SimonKrampe/Facharbeit-Informatik-Taschenrechner/Eagle/Renders/FinishedPCB_Bottom.png

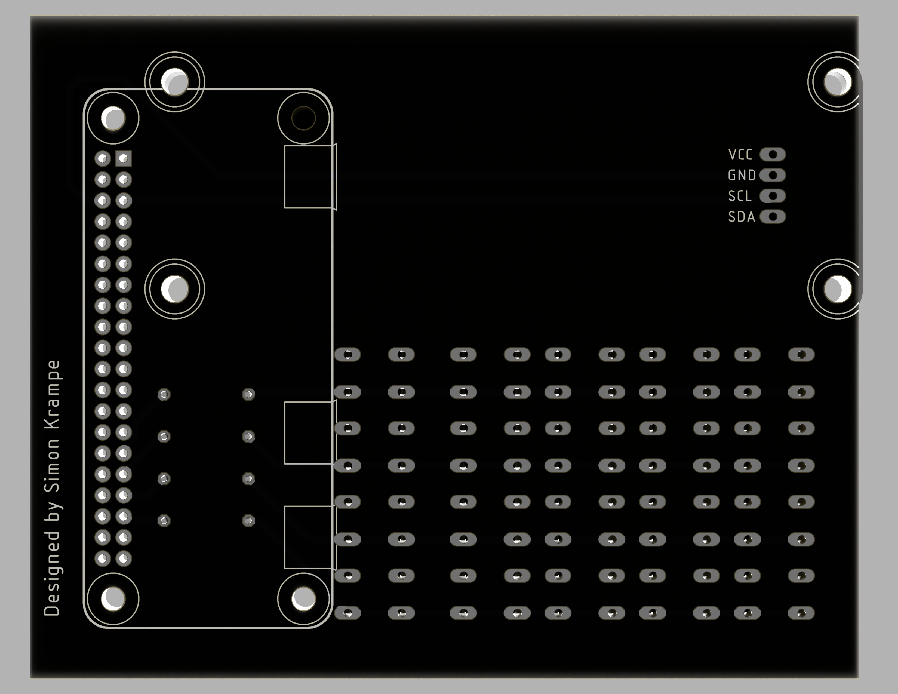
Eagle/Renders/FinishedPCB_Bottom.png
