SimonKrampe/Facharbeit-Informatik-Taschenrechner/Eagle/Renders/FinishedPCB_Clean.png

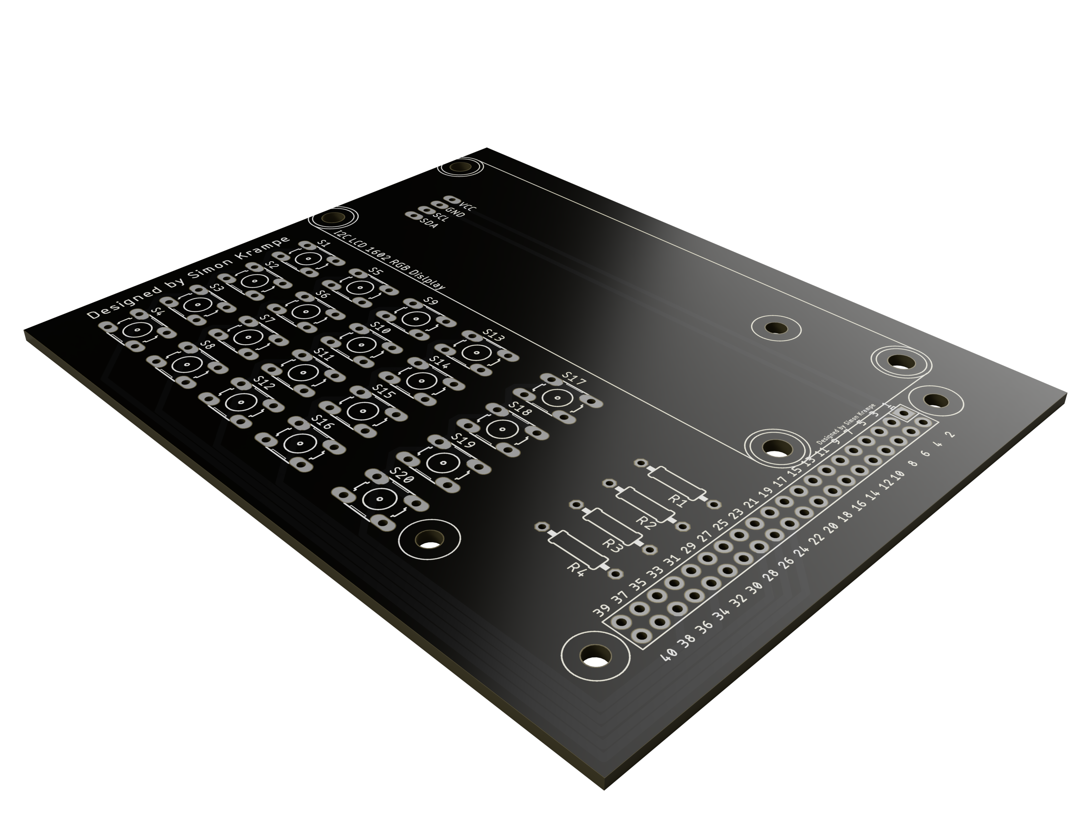
Eagle/Renders/FinishedPCB_Clean.png
