SimonKrampe/Facharbeit-Informatik-Taschenrechner/Eagle/Renders/FinishedPCB_Top_Clean.png

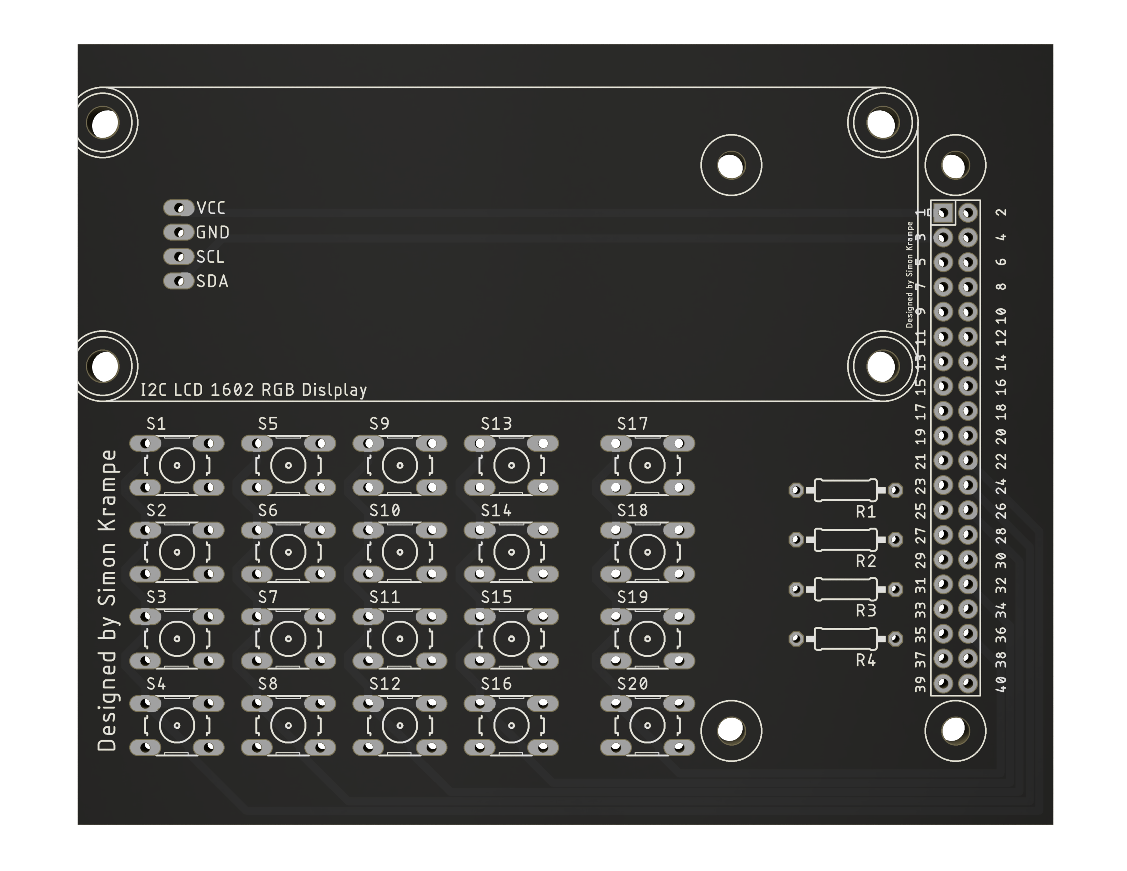
Eagle/Renders/FinishedPCB_Top_Clean.png
