SimonKrampe/Facharbeit-Informatik-Taschenrechner/Eagle/Renders/FinishedPCBAlternate.png

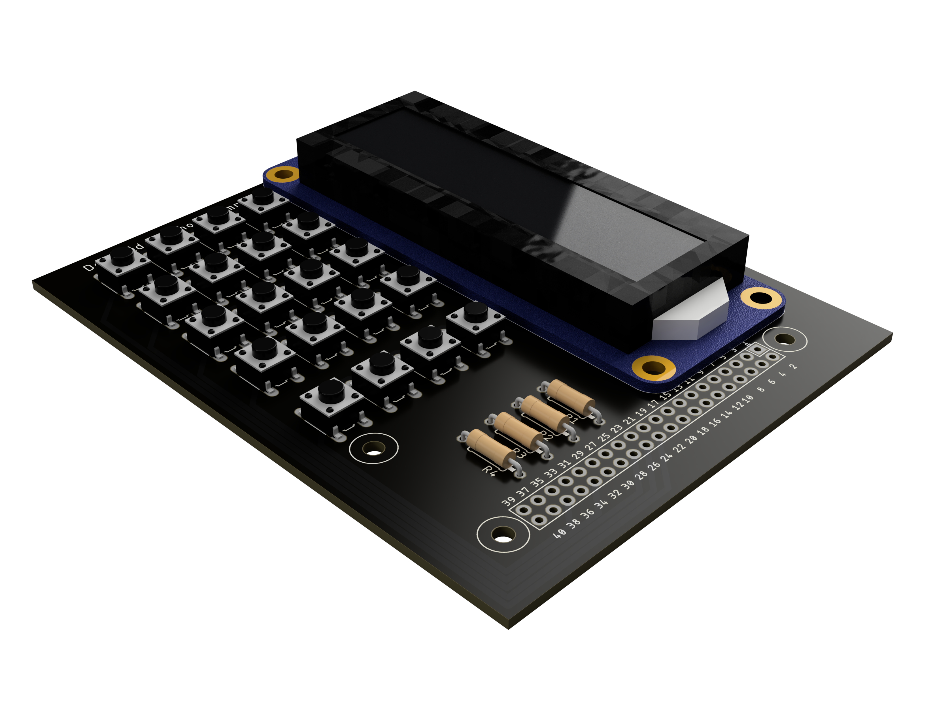
Eagle/Renders/FinishedPCBAlternate.png
