SimonKrampe/Facharbeit-Informatik-Taschenrechner/Fritzing/Button Matrix_Steckplatine4k.png

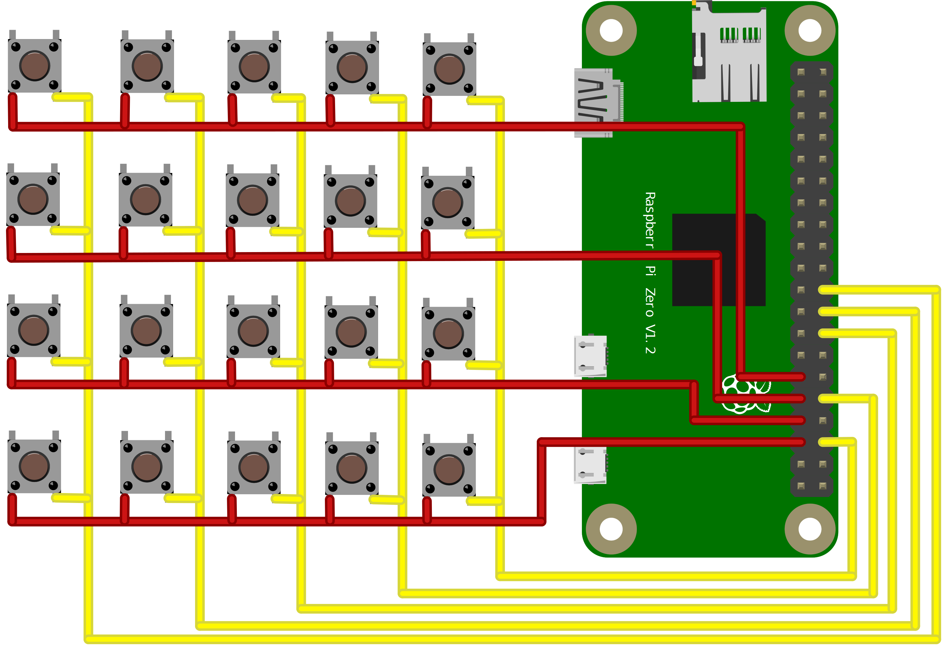
Fritzing/Button Matrix_Steckplatine4k.png
