SimonKrampe/Facharbeit-Informatik-Taschenrechner/Fritzing/Button Matrix_Steckplatine4k_Beschriftet.png

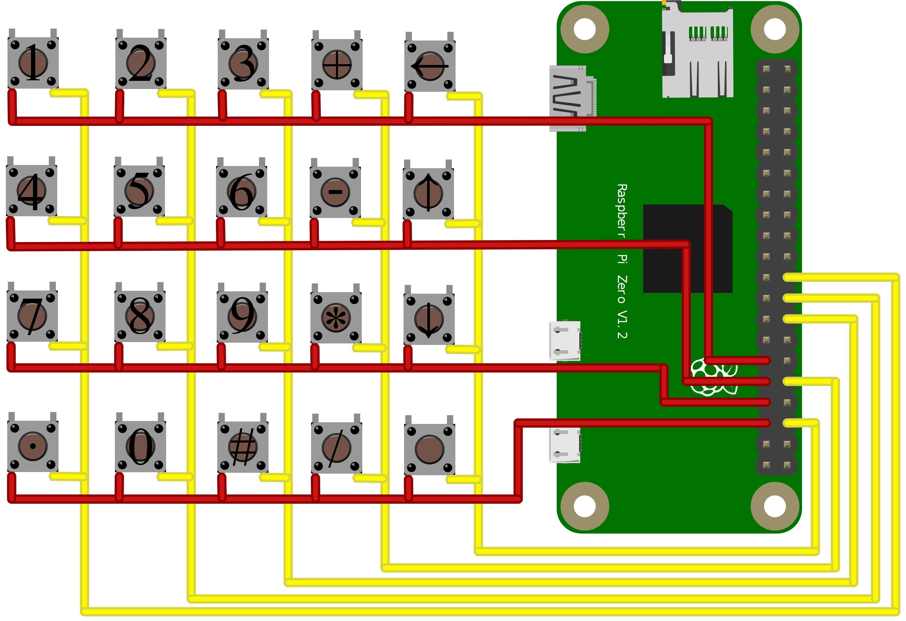
Fritzing/Button Matrix_Steckplatine4k_Beschriftet.png
