SimonKrampe/Facharbeit-Informatik-Taschenrechner/Fritzing/Button Matrix_Steckplatine.png

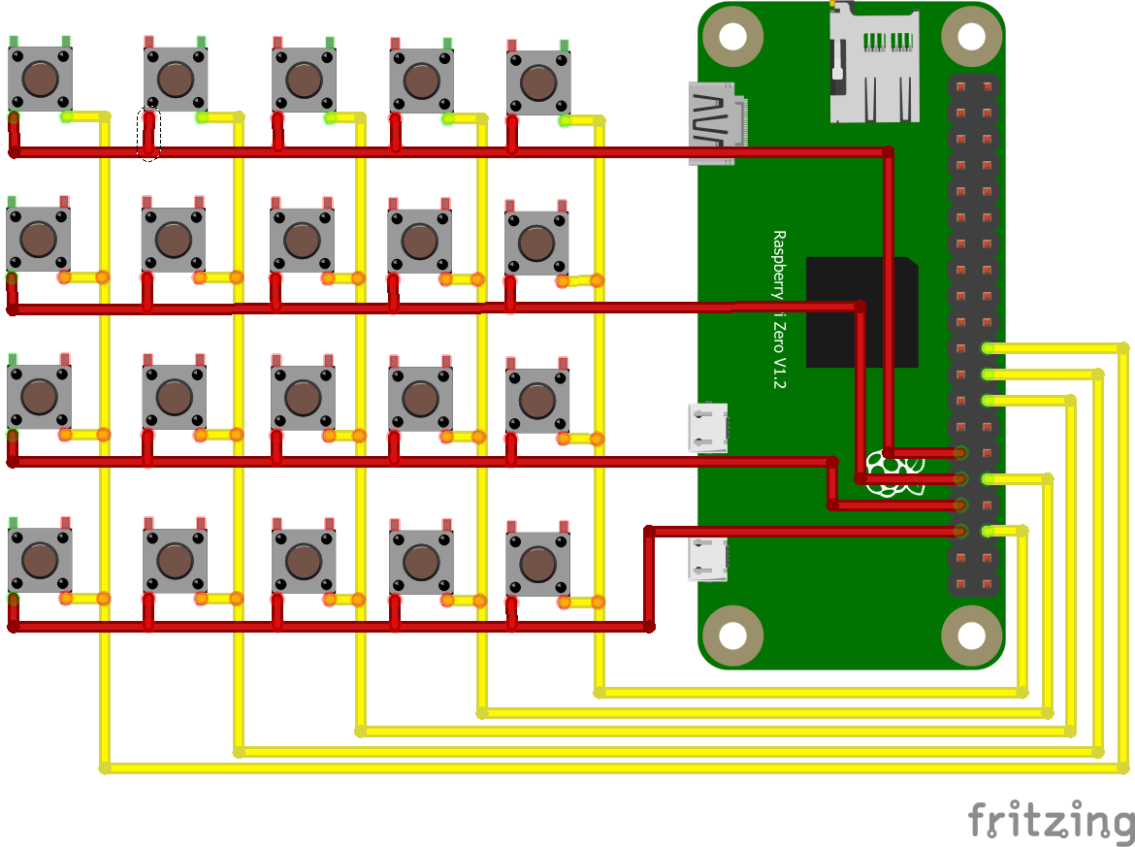
Fritzing/Button Matrix_Steckplatine.png
