SimonKrampe/Facharbeit-Informatik-Taschenrechner/Fritzing/I2C Display_Steckplatine.png

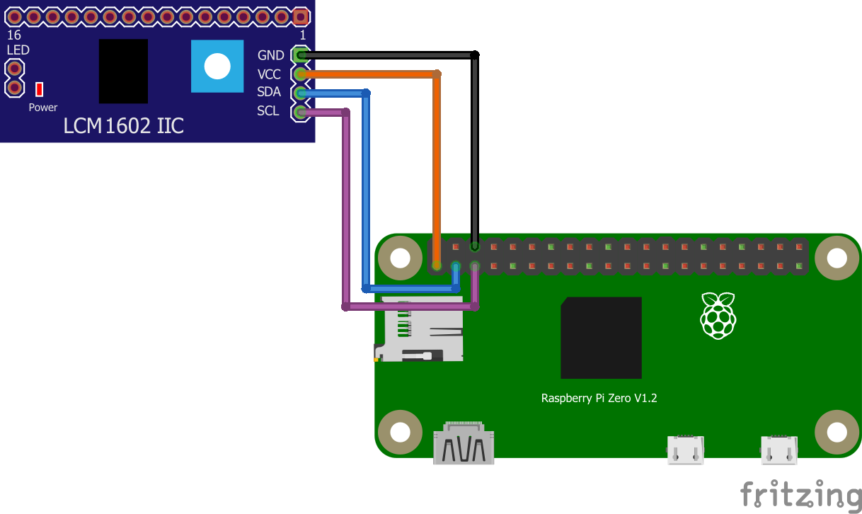
Fritzing/I2C Display_Steckplatine.png
