SimonKrampe/Facharbeit-Informatik-Taschenrechner/Rechner/Fotos/Laufzeitberechnung.png

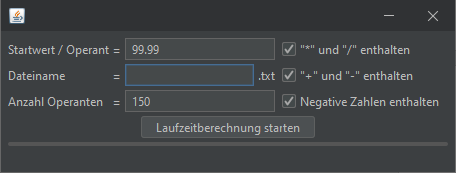
Rechner/Fotos/Laufzeitberechnung.png
