SimonKrampe/Facharbeit-Informatik-Taschenrechner/Rechner/Fotos/Rechner.png

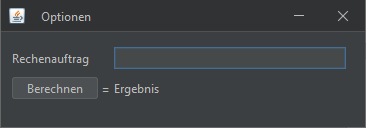
Rechner/Fotos/Rechner.png
