SimonKrampe/Facharbeit-Informatik-Taschenrechner/Rechner/Fotos/RechnerOptionen.png

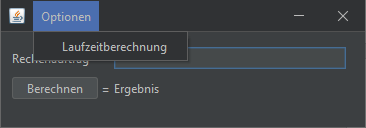
Rechner/Fotos/RechnerOptionen.png
