SimonKrampe/Facharbeit-Informatik-Taschenrechner/(list of files, cad)

Other CAD files:
Eagle/LCD1602 RGB Module v1.f3d
