SimonKrampe/Facharbeit-Informatik-Taschenrechner/Fritzing/Button Matrix_Steckplatine.pdf

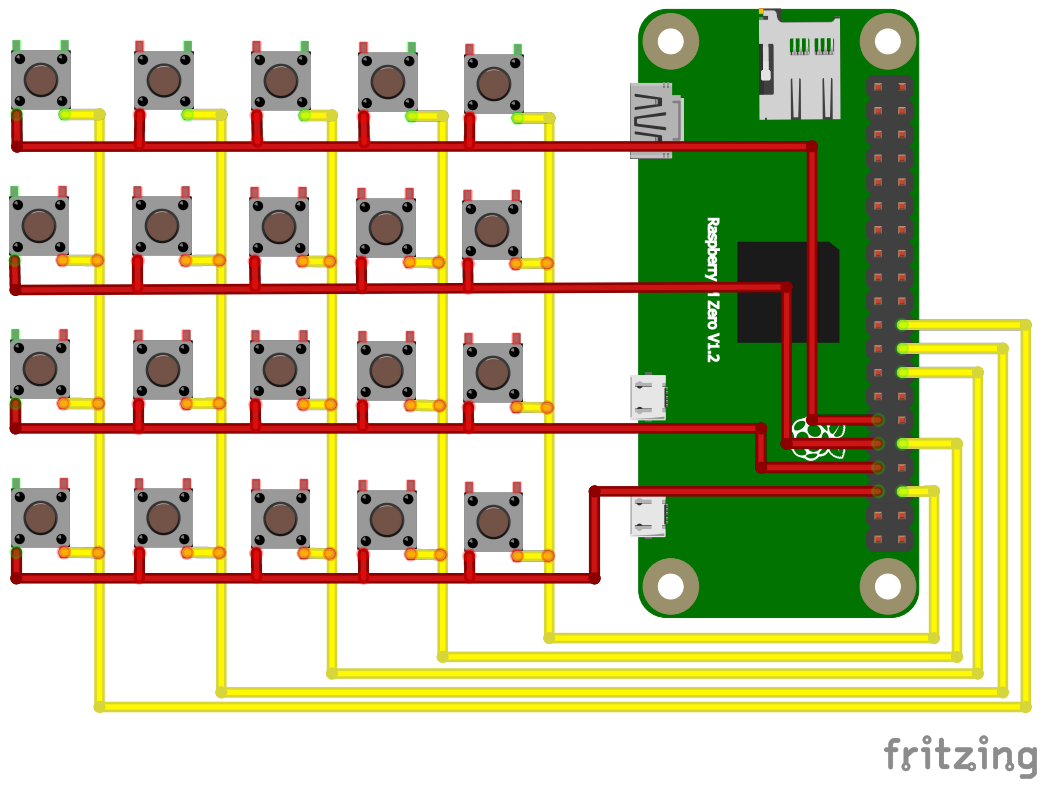
[picture p28: page 1]
