SimonKrampe/Facharbeit-Informatik-Taschenrechner/Fritzing/I2C Display_Steckplatine.pdf

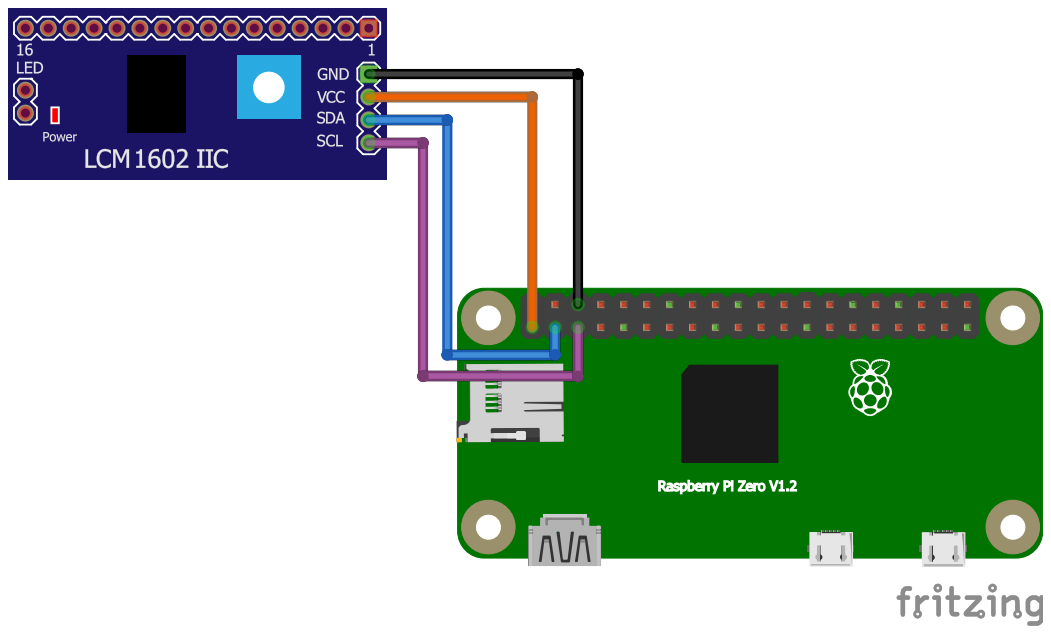
[picture p29: page 1]
