SimonKrampe/Facharbeit-Informatik-Taschenrechner/Eagle/TaschenrechnerPCBBoard.pdf

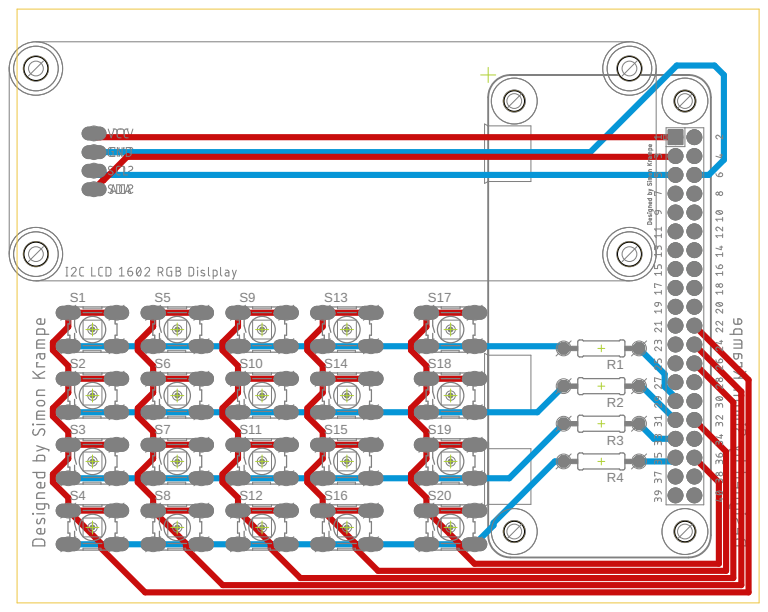
[picture p30: page 1]
