SimonKrampe/Facharbeit-Informatik-Taschenrechner/Eagle/TaschenrechnerPCBSchaltplan.pdf

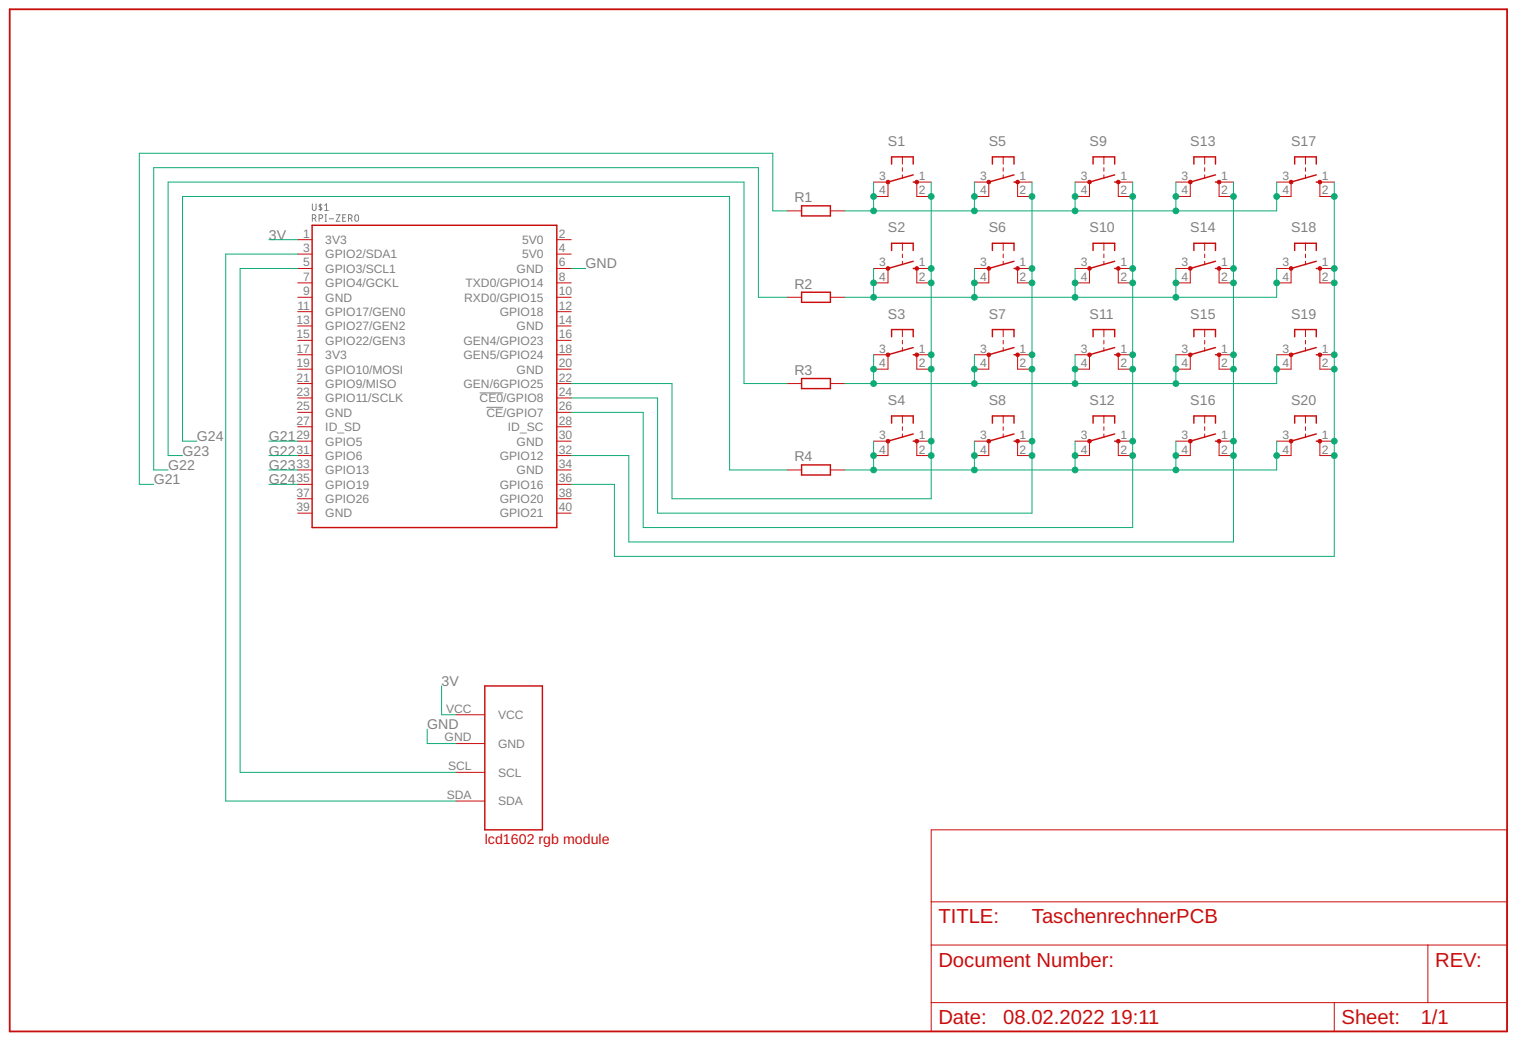
[picture p31: page 1]

Document Number: | REV:

Date: 08.02.2022 19:11 | Sheet: 1/1
