SimonKrampe/Facharbeit-Informatik-Taschenrechner/(list of files, drawings)

Other design files:
Fritzing/Button Matrix.fzz
Fritzing/I2C Display.fzz
