SimonKrampe/Facharbeit-Informatik-Taschenrechner/Eagle/TaschenrechnerPCB/TaschenrechnerPCB.brd

## EAGLE design Eagle/TaschenrechnerPCB/TaschenrechnerPCB.brd (2022-02-15)

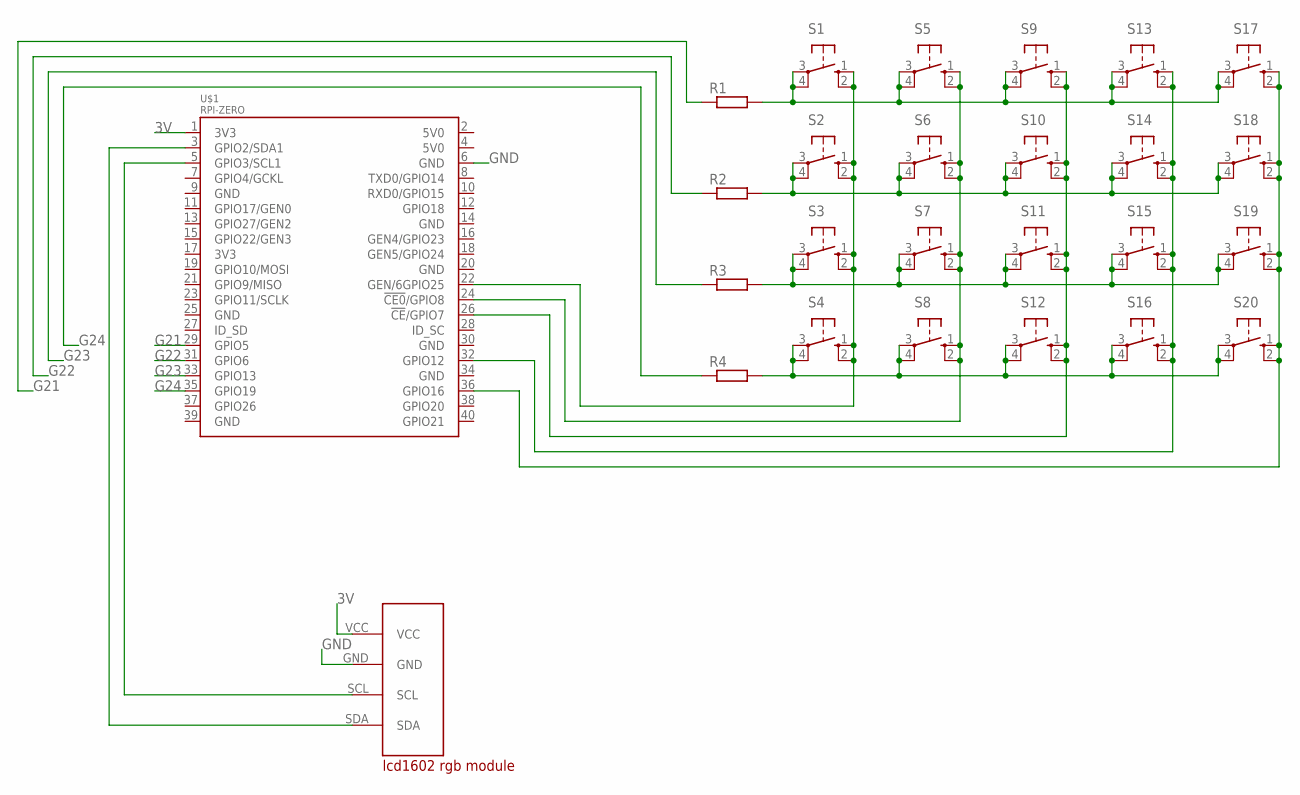
[picture p32: schematic TaschenrechnerPCB.sch]

Parts:
R1, R2, R3, R4: R-EU_0207/10; 0207/10
S1, S2, S3, S4, S5, S6, S7, S8, S9, S10, S11, S12, S13, S14, S15, S16, S17, S18, S19, S20: 10-XX; B3F-10XX
U$1: RPI-ZERO; RASP_PI_ZERO_BOARD_FULL
U$2: LCD1602-RGB-MODULE

Connections:
3V: U$1.1 (3V3), U$2.VCC
G6: S1.1 (S), S1.2 (S1), S2.1 (S), S2.2 (S1), S3.1 (S), S3.2 (S1), S4.1 (S), S4.2 (S1), U$1.22 (GEN/6GPIO25)
G10: S5.1 (S), S5.2 (S1), S6.1 (S), S6.2 (S1), S7.1 (S), S7.2 (S1), S8.1 (S), S8.2 (S1), U$1.24 (!CE0!/GPIO8)
G11: S9.1 (S), S9.2 (S1), S10.1 (S), S10.2 (S1), S11.1 (S), S11.2 (S1), S12.1 (S), S12.2 (S1), U$1.26 (!CE!/GPIO7)
G21: R1.1, U$1.29 (GPIO5)
G22: R2.1, U$1.31 (GPIO6)
G23: R3.1, U$1.33 (GPIO13)
G24: R4.1, U$1.35 (GPIO19)
G26: S13.1 (S), S13.2 (S1), S14.1 (S), S14.2 (S1), S15.1 (S), S15.2 (S1), S16.1 (S), S16.2 (S1), U$1.32 (GPIO12)
G27: S17.1 (S), S17.2 (S1), S18.1 (S), S18.2 (S1), S19.1 (S), S19.2 (S1), S20.1 (S), S20.2 (S1), U$1.36 (GPIO16)
GND: U$1.6 (GND), U$2.GND
unnamed: U$1.3 (GPIO2/SDA1), U$2.SDA
unnamed: U$1.5 (GPIO3/SCL1), U$2.SCL
unnamed: R1.2, S1.3, S1.4 (P1), S5.3, S5.4 (P1), S9.3, S9.4 (P1), S13.3, S13.4 (P1), S17.3, S17.4 (P1)
unnamed: R2.2, S2.3, S2.4 (P1), S6.3, S6.4 (P1), S10.3, S10.4 (P1), S14.3, S14.4 (P1), S18.3, S18.4 (P1)
unnamed: R3.2, S3.3, S3.4 (P1), S7.3, S7.4 (P1), S11.3, S11.4 (P1), S15.3, S15.4 (P1), S19.3, S19.4 (P1)
unnamed: R4.2, S4.3, S4.4 (P1), S8.3, S8.4 (P1), S12.3, S12.4 (P1), S16.3, S16.4 (P1), S20.3, S20.4 (P1)

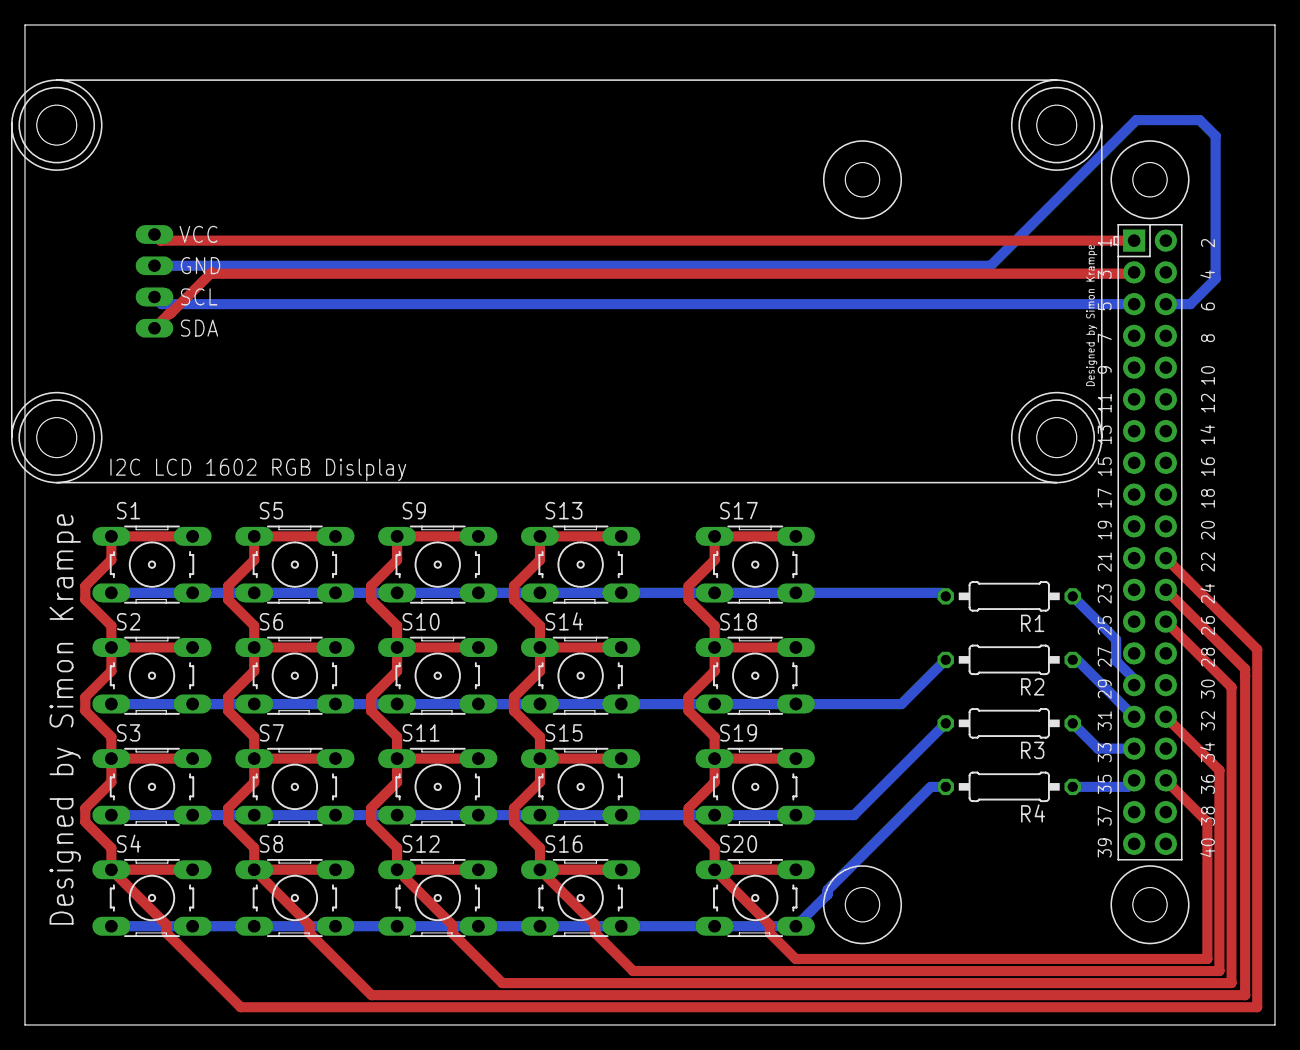
[picture p33: board TaschenrechnerPCB.brd from above]

Board: 2 copper layers, 100.0 x 80.0 mm, 26 parts (0 on the bottom side), 17 nets.
