SimonKrampe/Facharbeit-Informatik-Taschenrechner/(commit log)

2022-02-15 Eagle, Fritzing und Bilder hinzugefügt
    [Button Matrix.fzz, I2C Display.fzz, LCD1602 RGB Module v1.f3d, TaschenrechnerPCB.brd, TaschenrechnerPCB.sch]
2022-02-17 Einige Dateien hinzugefügt
    [Laufzeit.xlsx]
